francobottini99/MIPSFPGA-2023/vivado.src/sources/mips/hazard/src/risk_detection.v

`timescale 1ns / 1ps

`include "risk_detection.vh"

module risk_detection
    (
        input  wire         i_jmp_stop,
        input  wire [4 : 0] i_if_id_rs,
        input  wire [4 : 0] i_if_id_rd,
        input  wire [5 : 0] i_if_id_op,
        input  wire [5 : 0] i_if_id_funct,
        input  wire [4 : 0] i_id_ex_rt,
        input  wire [5 : 0] i_id_ex_op,
        output wire         o_jmp_stop,
        output wire         o_not_load,
        output wire         o_halt,
        output wire         o_ctr_reg_src
    );

    assign o_jmp_stop    = ((i_if_id_funct == `CODE_FUNCT_JALR || i_if_id_funct == `CODE_FUNCT_JR  && i_if_id_op == `CODE_OP_R_TYPE) ||
                            (i_if_id_op    == `CODE_OP_BNE     || i_if_id_op    ==  `CODE_OP_BEQ)) && !i_jmp_stop;

    assign o_halt        = i_if_id_op == `CODE_OP_HALT;

    assign o_not_load    = ((i_id_ex_rt == i_if_id_rs     || i_id_ex_rt == i_if_id_rd)  && 
                            (i_id_ex_op == `CODE_OP_LW    || i_id_ex_op == `CODE_OP_LB  || 
                             i_id_ex_op == `CODE_OP_LBU   || i_id_ex_op == `CODE_OP_LH  || 
                             i_id_ex_op == `CODE_OP_LHU   || i_id_ex_op == `CODE_OP_LUI ||
                             i_id_ex_op == `CODE_OP_LWU)) || o_jmp_stop;     
      
    assign o_ctr_reg_src = o_not_load;

endmodule
