francobottini99/MIPSFPGA-2023/vivado.src/sim/mips/hazard/tb_risk_detection.v

`timescale 1ns / 1ps

`include "tb.vh"
`include "codes.vh"

module tb_risk_detection;

    reg        i_jmp_stop;
    reg  [4:0] i_if_id_rs, i_if_id_rd;
    reg  [5:0] i_if_id_op, i_if_id_funct;
    reg  [4:0] i_id_ex_rt;
    reg  [5:0] i_id_ex_op;
    wire       o_not_load, o_halt, o_ctr_reg_src, o_jmp_stop;

    risk_detection dut 
    (
        .i_jmp_stop      (i_jmp_stop),
        .i_if_id_rs      (i_if_id_rs),
        .i_if_id_rd      (i_if_id_rd),
        .i_if_id_funct   (i_if_id_funct),
        .i_if_id_op      (i_if_id_op),
        .i_id_ex_rt      (i_id_ex_rt),
        .i_id_ex_op      (i_id_ex_op),
        .o_jmp_stop      (o_jmp_stop),
        .o_not_load      (o_not_load),
        .o_halt          (o_halt),
        .o_ctr_reg_src   (o_ctr_reg_src)
    );

    initial 
    begin
        i_if_id_op = 0;
        
        i_if_id_rs = 4;
        i_id_ex_rt = 4; 
        i_id_ex_op = `CODE_OP_LB;

        #10;
        if (o_not_load !== 1'b1)
            $display("Failed test for Load Hazard");
        else
            $display("Successful test for Load Hazard");

        i_jmp_stop = 1'b0;
        i_if_id_funct = `CODE_FUNCT_JALR;
        i_if_id_op = `CODE_OP_R_TYPE;
        #10;
        if (o_jmp_stop !== 1'b1)
            $display("Failed test for Jump Stop");
        else
            $display("Successful test for Jump Stop");

        i_if_id_op = `CODE_OP_HALT;

        #10;
        if (o_halt !== 1'b1)
            $display("Failed test for Halt");
        else
            $display("successful test for Halt");

        $finish;
    end
endmodule
